camilacolussi/tectonic-lingering-sculpture/media/Making_connections2.jpg

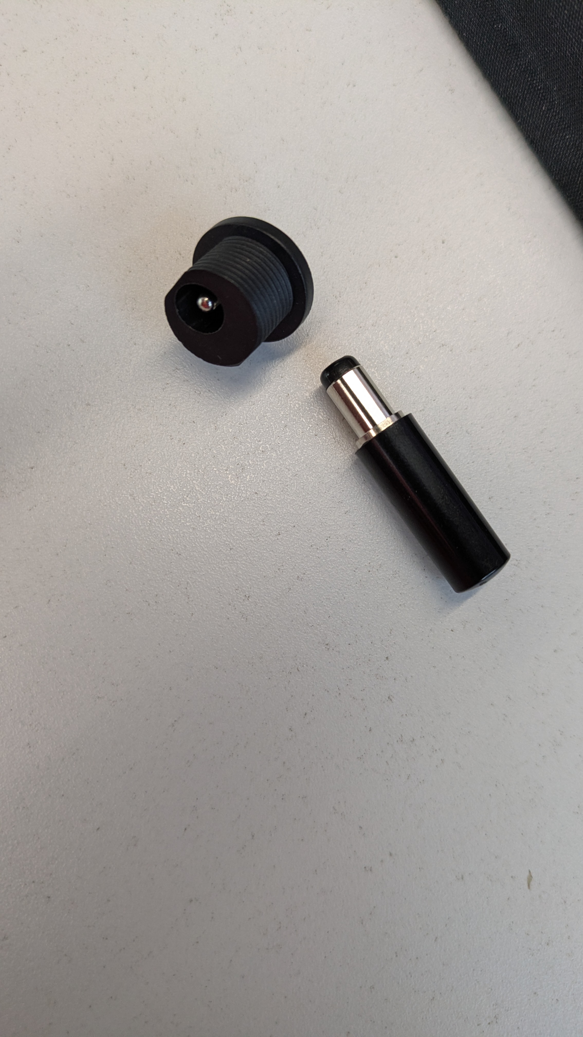
media/Making_connections2.jpg
