camilacolussi/tectonic-lingering-sculpture/media/Making_connections1.jpg

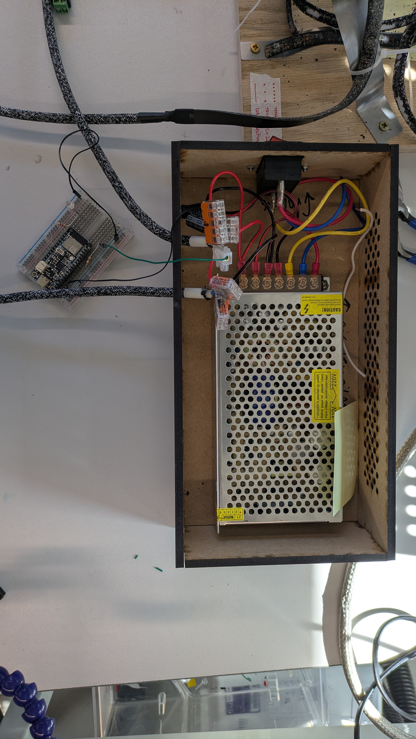
media/Making_connections1.jpg
