camilacolussi/tectonic-lingering-sculpture/media/Process_1.png

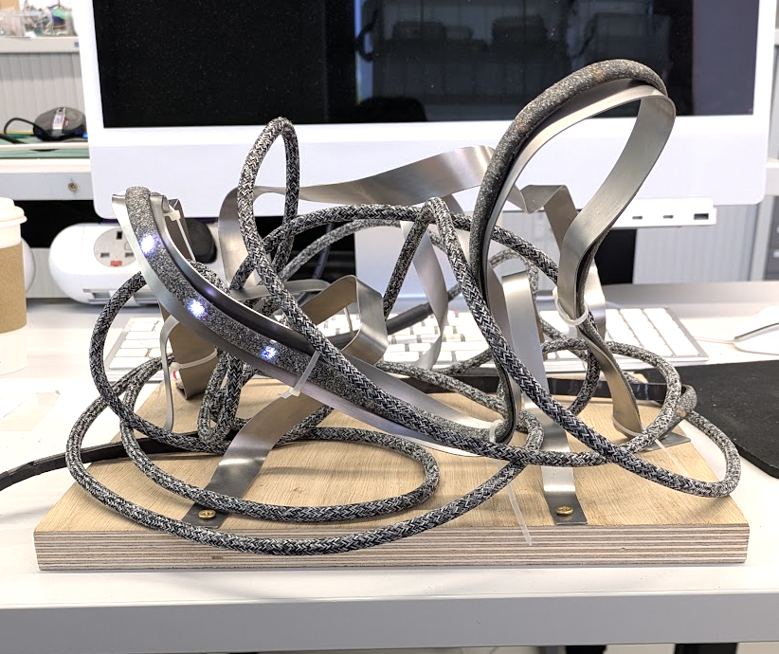
media/Process_1.png
