camilacolussi/tectonic-lingering-sculpture/(commit log)

2026-07-31 Clarify LED strip model in stage 1 notes
2026-07-31 Add initial documentation for Stage 1 and project roadmap
2026-08-06 // Select board: Adafruit Feather ESP32-S3 No PSRAM
2026-08-06 Add LED motion test and touch test sketches for ESP32-S3
2026-08-06 Refactor project structure and documentation for clarity and organization
    - Updated CLAUDE.md to reflect changes in project architecture and documentation practices.
    - Revised README.md to describe the new two-system approach and updated hardware details.
    - Enhanced roadmap.md with architectural decisions and clarified project goals for each system.
    - Created detailed notes for System 1 (API + LEDs) and System 2 (Touch + Sound) to document architecture, hardware, and open questions.
    - Updated tutorial.md to align with new system structure and provide clear wiring instructions.
    - Removed obsolete LED test sketch (03_led_test2.ino) and adjusted existing test sketches for clarity and accuracy.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
2026-08-07 error uploading blink on a ESP32 V2 - solved
    [01_led_test.ino]
